harshpatel097/Chess-Playing-AI-Bot/STL files of 3D printed parts/Elbow/Motor-Mount.STL

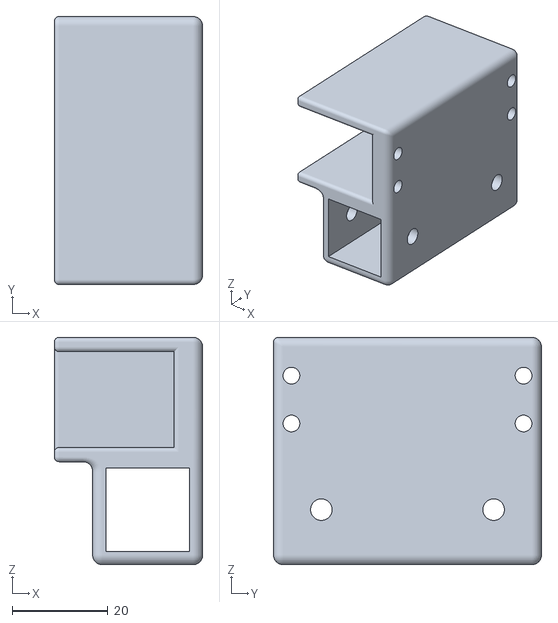
[picture p4: CAD file, 2019-03-30]
STL files of 3D printed parts/Elbow/Motor-Mount.STL
31.0 x 56.0 x 47.5
