harshpatel097/Chess-Playing-AI-Bot/STL files of 3D printed parts/Gripper/Arm 1.STL

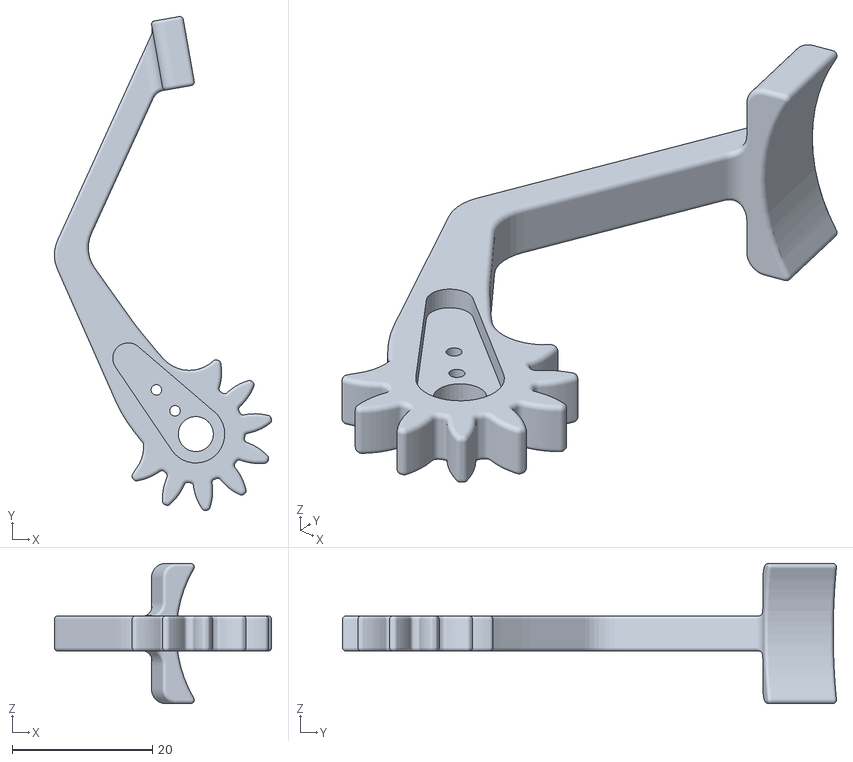
[picture p5: CAD file, 2019-03-30]
STL files of 3D printed parts/Gripper/Arm 1.STL
31.0 x 70.5 x 20.0
