harshpatel097/Chess-Playing-AI-Bot/STL files of 3D printed parts/Pipe Base.STL

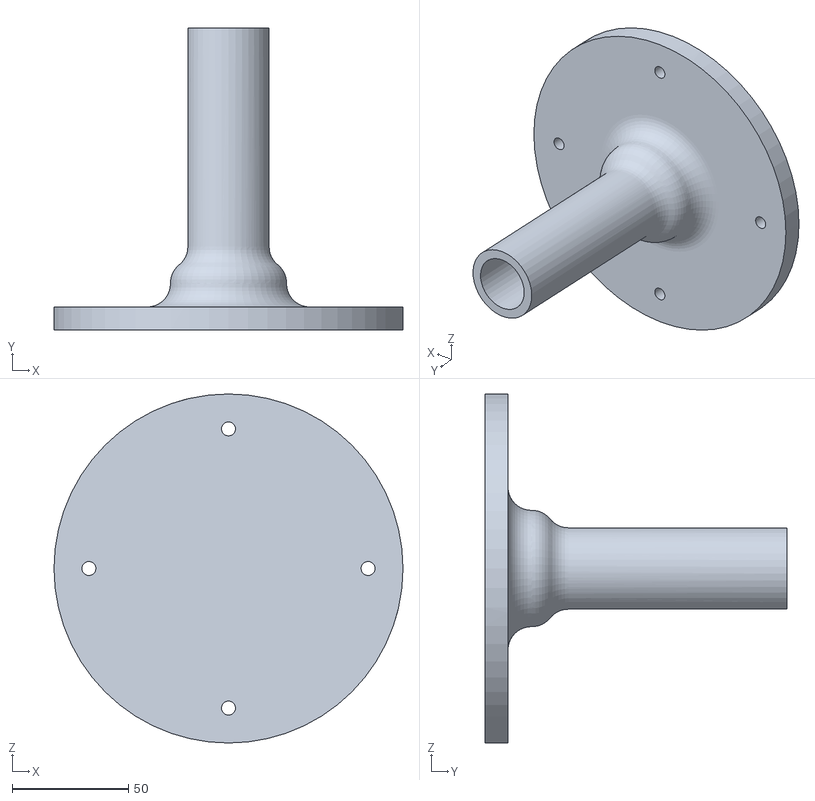
[picture p6: CAD file, 2019-03-30]
STL files of 3D printed parts/Pipe Base.STL
150.0 x 130.0 x 150.0
