harshpatel097/Chess-Playing-AI-Bot/STL files of 3D printed parts/Rack and Pinion/Pinion.STL

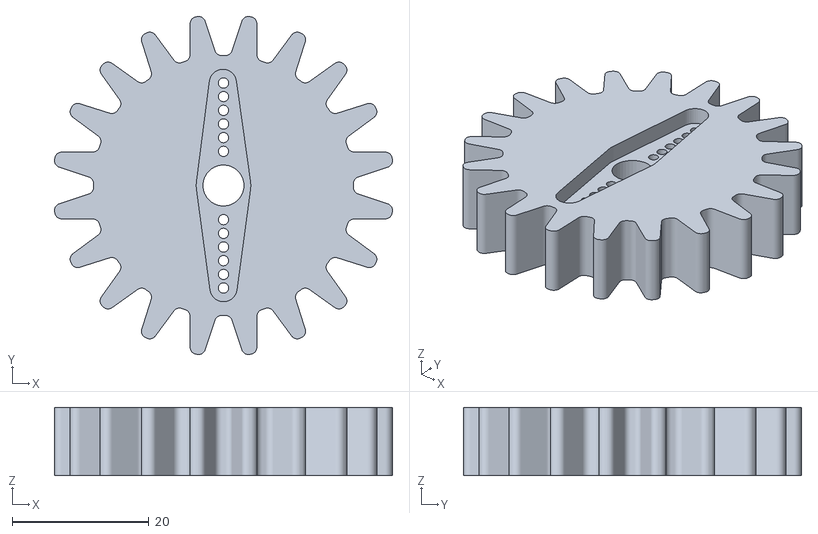
[picture p7: CAD file, 2019-03-30]
STL files of 3D printed parts/Rack and Pinion/Pinion.STL
49.4 x 49.4 x 10.0
