harshpatel097/Chess-Playing-AI-Bot/STL files of 3D printed parts/RasPi and PiCam/Pi Cam Case.STL

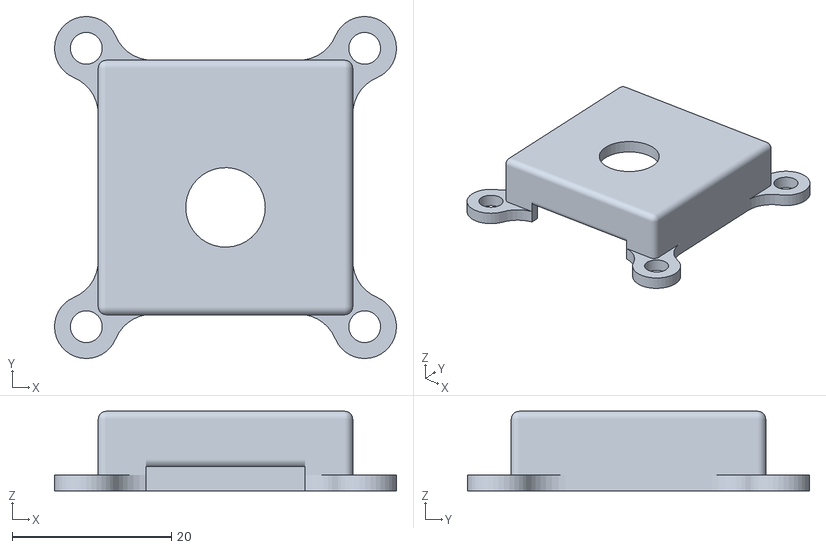
[picture p8: CAD file, 2019-03-30]
STL files of 3D printed parts/RasPi and PiCam/Pi Cam Case.STL
43.0 x 43.0 x 10.0
