harshpatel097/Chess-Playing-AI-Bot/STL files of 3D printed parts/Shoulder/SquareChannel-Mount.STL

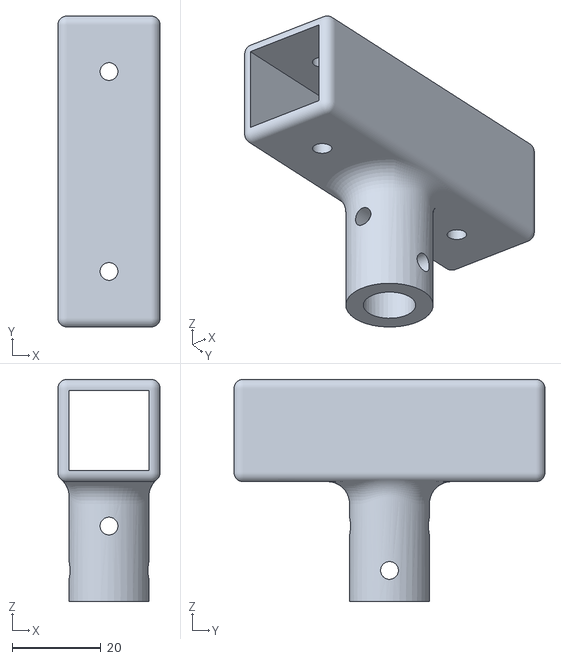
[picture p9: CAD file, 2019-03-30]
STL files of 3D printed parts/Shoulder/SquareChannel-Mount.STL
23.0 x 70.0 x 50.0
