harshpatel097/Chess-Playing-AI-Bot/STL files of 3D printed parts/Elbow/Disc.STL

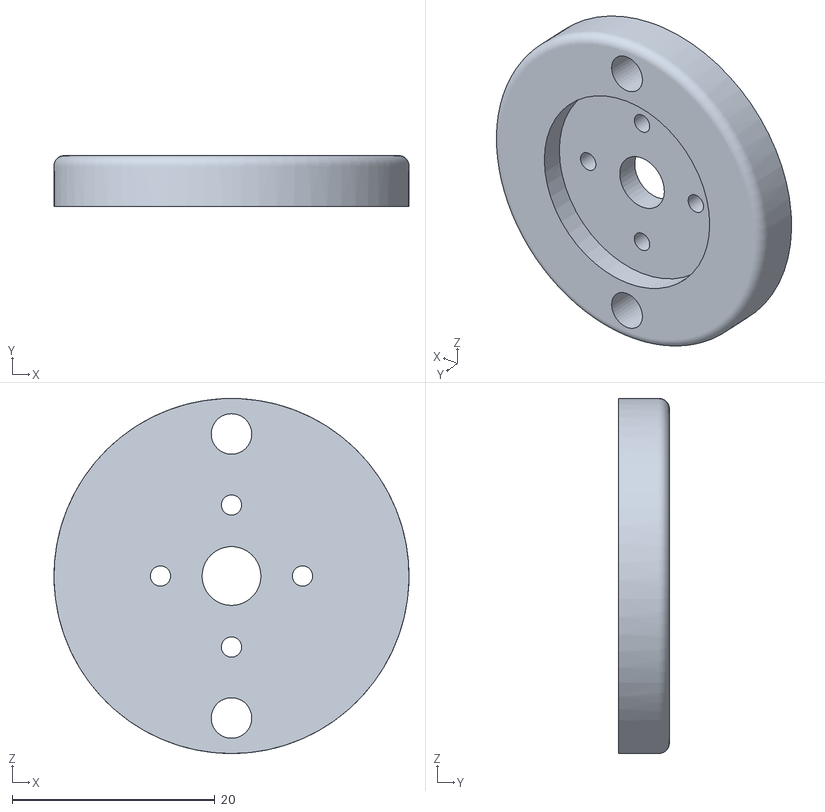
[picture p10: CAD file, 2019-03-30]
STL files of 3D printed parts/Elbow/Disc.STL
35.0 x 5.00 x 35.0
