harshpatel097/Chess-Playing-AI-Bot/STL files of 3D printed parts/Gripper/Top.STL

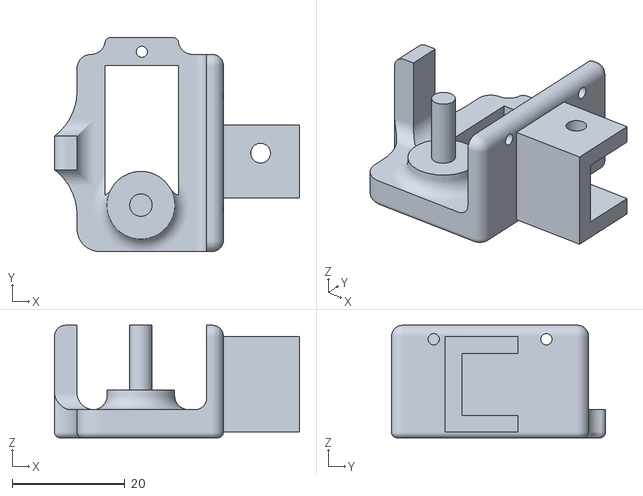
[picture p11: CAD file, 2019-03-30]
STL files of 3D printed parts/Gripper/Top.STL
43.5 x 38.0 x 20.0
