harshpatel097/Chess-Playing-AI-Bot/STL files of 3D printed parts/Rack and Pinion/Rack Mount.STL

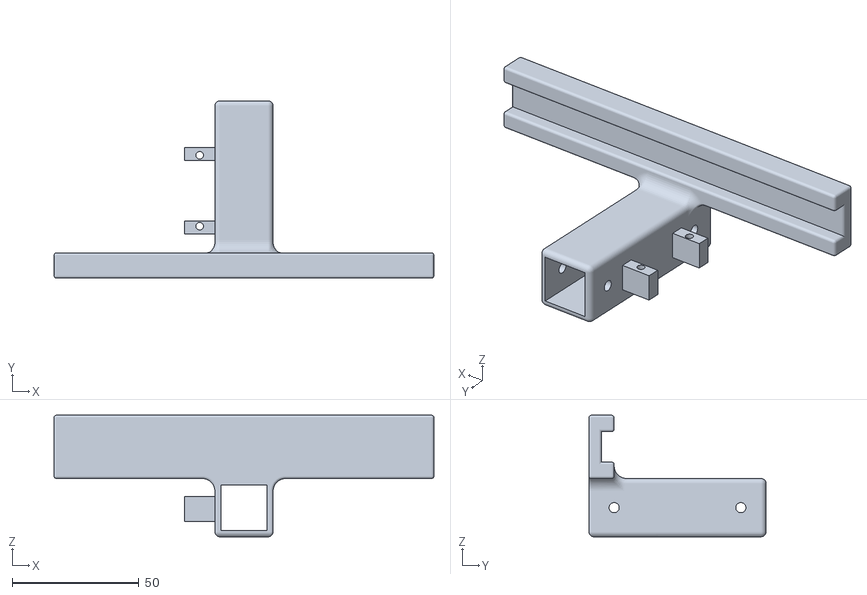
[picture p12: CAD file, 2019-03-30]
STL files of 3D printed parts/Rack and Pinion/Rack Mount.STL
150.0 x 70.0 x 48.0
