harshpatel097/Chess-Playing-AI-Bot/STL files of 3D printed parts/RasPi and PiCam/Mount.STL

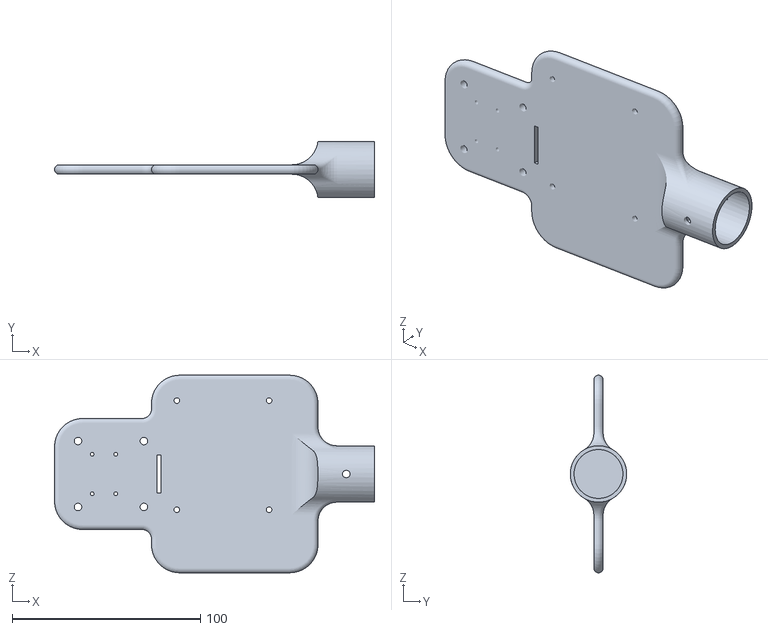
[picture p13: CAD file, 2019-03-30]
STL files of 3D printed parts/RasPi and PiCam/Mount.STL
170.0 x 30.0 x 105.0
