harshpatel097/Chess-Playing-AI-Bot/STL files of 3D printed parts/Shoulder/Shaft.STL

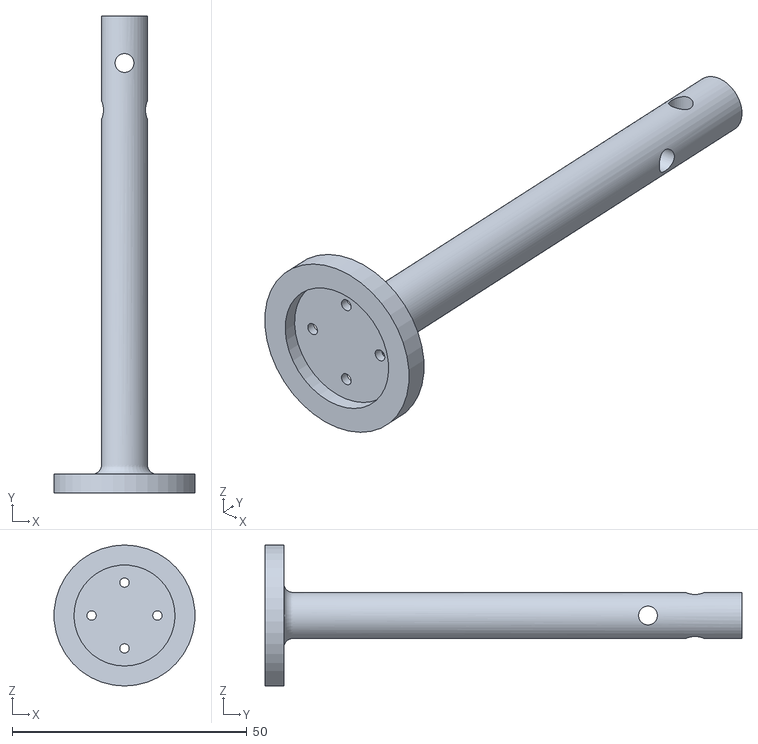
[picture p14: CAD file, 2019-03-30]
STL files of 3D printed parts/Shoulder/Shaft.STL
29.9 x 101.5 x 30.0
