harshpatel097/Chess-Playing-AI-Bot/STL files of 3D printed parts/Elbow/SqaureChannel-Mount.STL

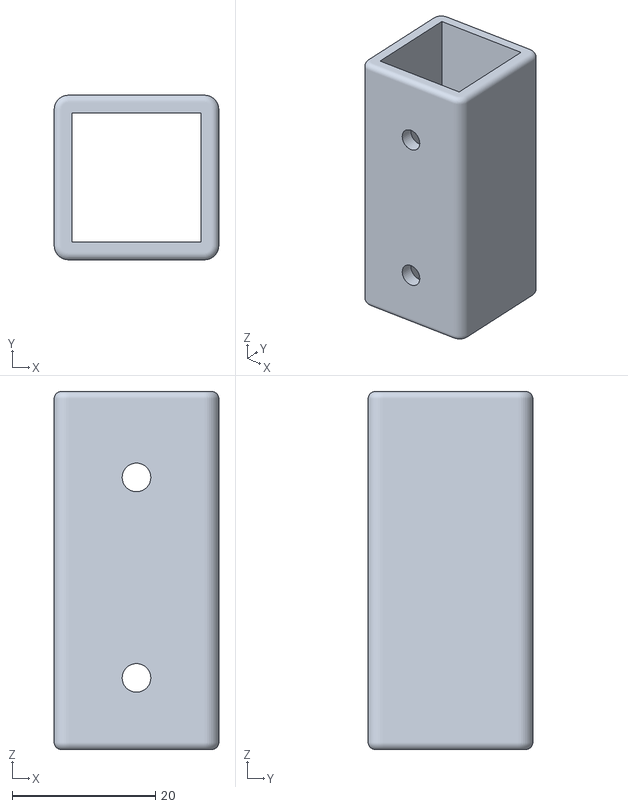
[picture p15: CAD file, 2019-03-30]
STL files of 3D printed parts/Elbow/SqaureChannel-Mount.STL
23.0 x 23.0 x 50.0
