harshpatel097/Chess-Playing-AI-Bot/STL files of 3D printed parts/Gripper/Arm 2.STL

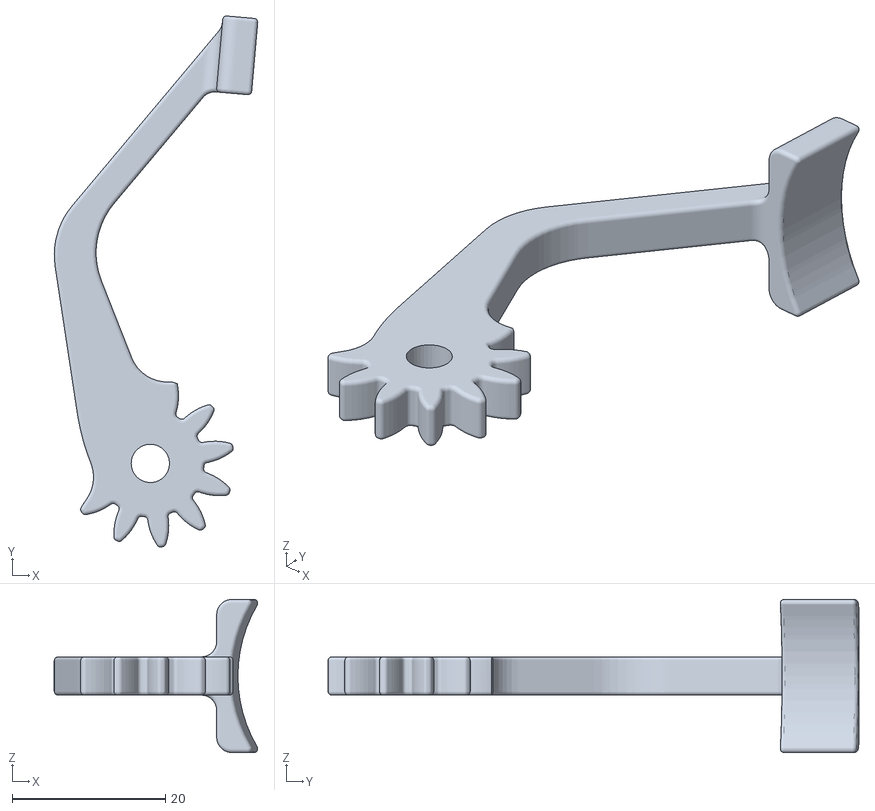
[picture p16: CAD file, 2019-03-30]
STL files of 3D printed parts/Gripper/Arm 2.STL
26.6 x 69.3 x 20.0
