harshpatel097/Chess-Playing-AI-Bot/STL files of 3D printed parts/Rack and Pinion/Rack.STL

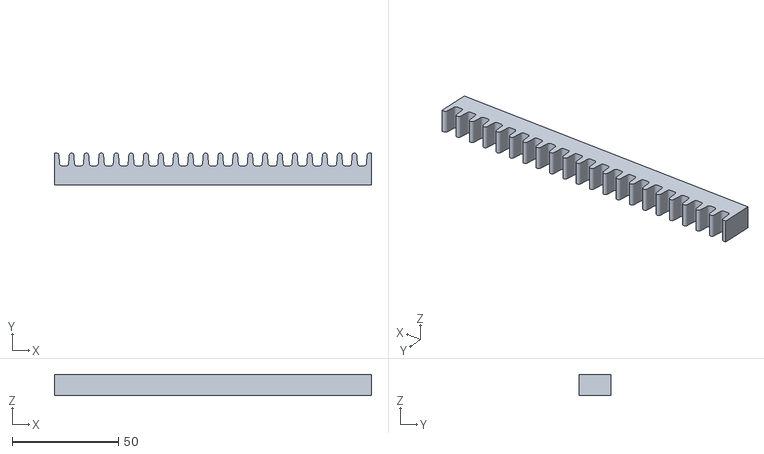
[picture p17: CAD file, 2019-03-30]
STL files of 3D printed parts/Rack and Pinion/Rack.STL
149.0 x 15.0 x 10.0
