harshpatel097/Chess-Playing-AI-Bot/STL files of 3D printed parts/Shoulder/Base.STL

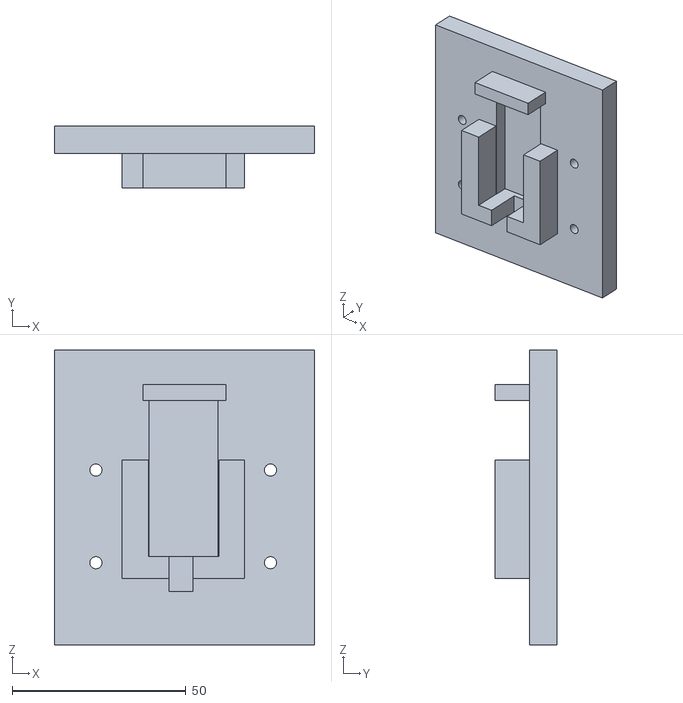
[picture p18: CAD file, 2019-03-30]
STL files of 3D printed parts/Shoulder/Base.STL
75.0 x 18.0 x 85.0
