harshpatel097/Chess-Playing-AI-Bot/STL files of 3D printed parts/Gripper/Bottom.STL

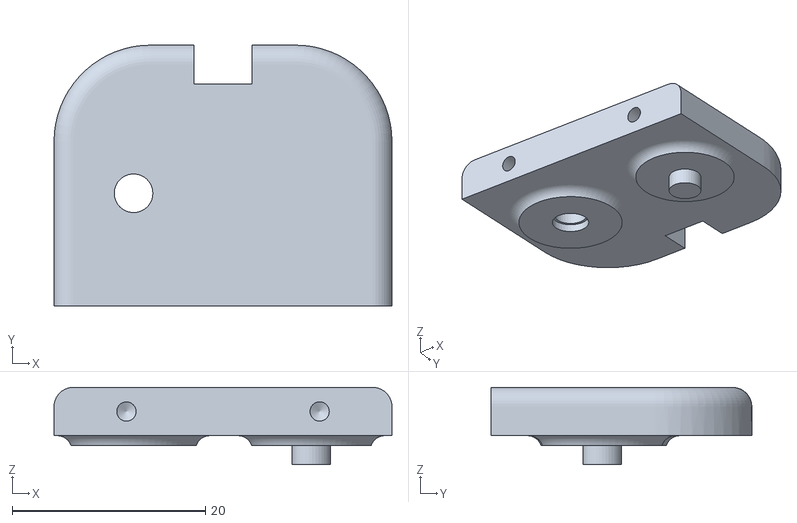
[picture p19: CAD file, 2019-03-30]
STL files of 3D printed parts/Gripper/Bottom.STL
35.0 x 27.0 x 8.00
