harshpatel097/Chess-Playing-AI-Bot/STL files of 3D printed parts/Shoulder/Base-Height.STL

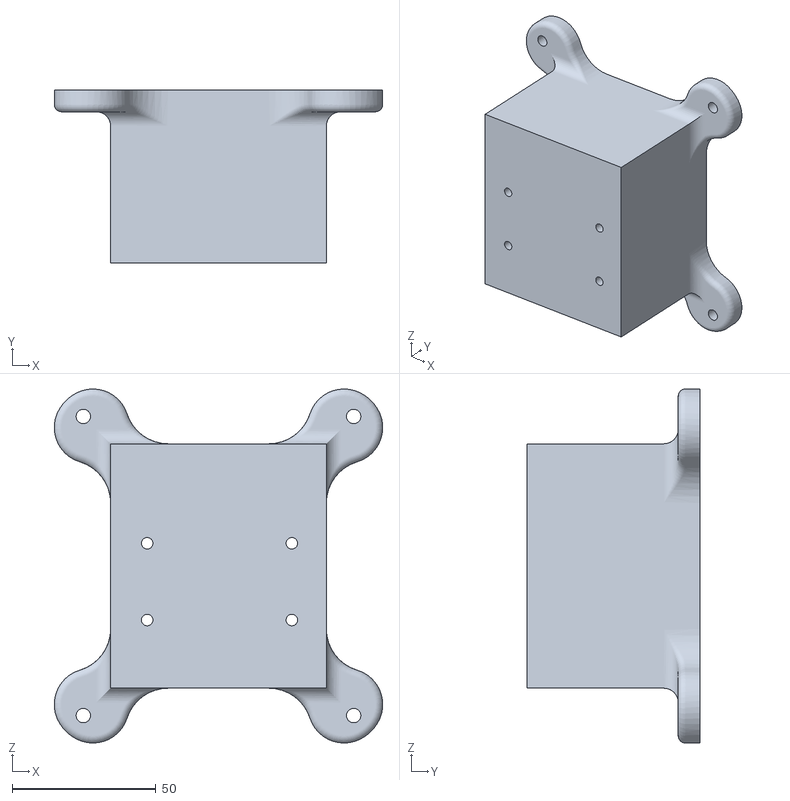
[picture p20: CAD file, 2019-03-30]
STL files of 3D printed parts/Shoulder/Base-Height.STL
114.2 x 60.0 x 123.1
