harshpatel097/Chess-Playing-AI-Bot/STL files of 3D printed parts/Shoulder/Bearing Mount.STL

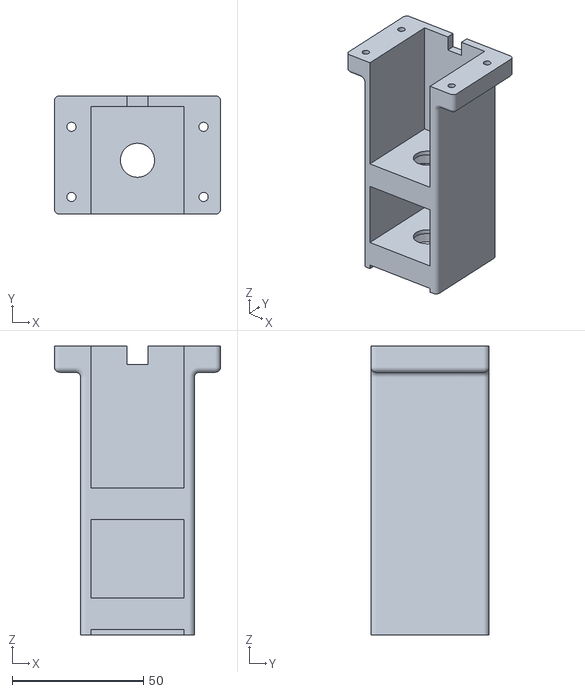
[picture p21: CAD file, 2019-03-30]
STL files of 3D printed parts/Shoulder/Bearing Mount.STL
63.3 x 45.0 x 110.0
